1213tnals/CoffeeRobot/jinwoo-arduino_main/about_code.md

*핀번호   
주행모터   
DIR1: 2, PWM1: 3, DIR2: 4, PWM2: 5    
   
IR센서   
IR_F: 38, IR_R: 40, IR_L: 42   
   
초음파센서   
TRIG_F: 24, EHCO_F: 26, TRIG_L: 25, ECHO_L: 27, TRIG_R: 28, ECHO_R: 29   
   
A_시리얼   
TX: 50, RX: 51
