1213tnals/CoffeeRobot/Readme_data/design.png

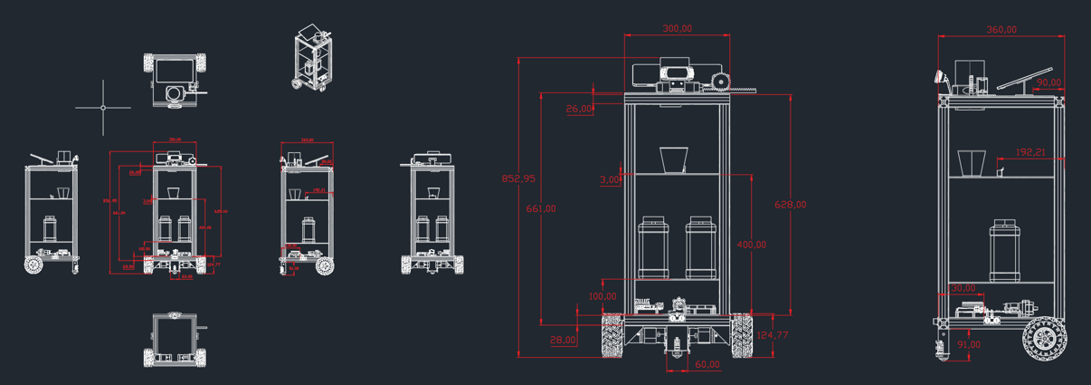
Readme_data/design.png
