1213tnals/CoffeeRobot/sumin-communication/beginner_tutorials/scripts/talker_orin.py

import rospy
from std_msgs.msg import Int32

def talker():
    pub = rospy.Publisher('unity/home', Int32, queue_size=10)
    rospy.init_node('talker', anonymous=True)
    rate = rospy.Rate(10) # 10hz
    while not rospy.is_shutdown():
        hello_str = int(1)
        rospy.loginfo(hello_str)
        pub.publish(hello_str)
        rate.sleep()

if __name__ == '__main__':
    try:
        talker()
    except rospy.ROSInterruptException:
        pass
