1213tnals/CoffeeRobot/(commit log)

2022-11-11 라인 트래킹 + 초음파 센서 장애물 회피 알고리즘 추가
2022-11-12 펠티어 소자코드 추가
2022-11-17 워터펌프
2022-11-19 파일명 수정
2022-11-19 yolov5 수정
2022-11-19 yolov5 필요한 파일들
2022-11-19 yolov5 수정완료
2022-11-19 워터펌프까지 합침
2022-11-21 pin fixed
2022-11-24 3 IR Sensor code is added
2022-11-25 추가수정본
2022-11-25 ultrasonic_code is added
